TobleMiner/SolarCamPiV2/SolarCamPiV2.kicad_pcb

## KiCad design SolarCamPiV2.kicad_pcb (2022-05-29)

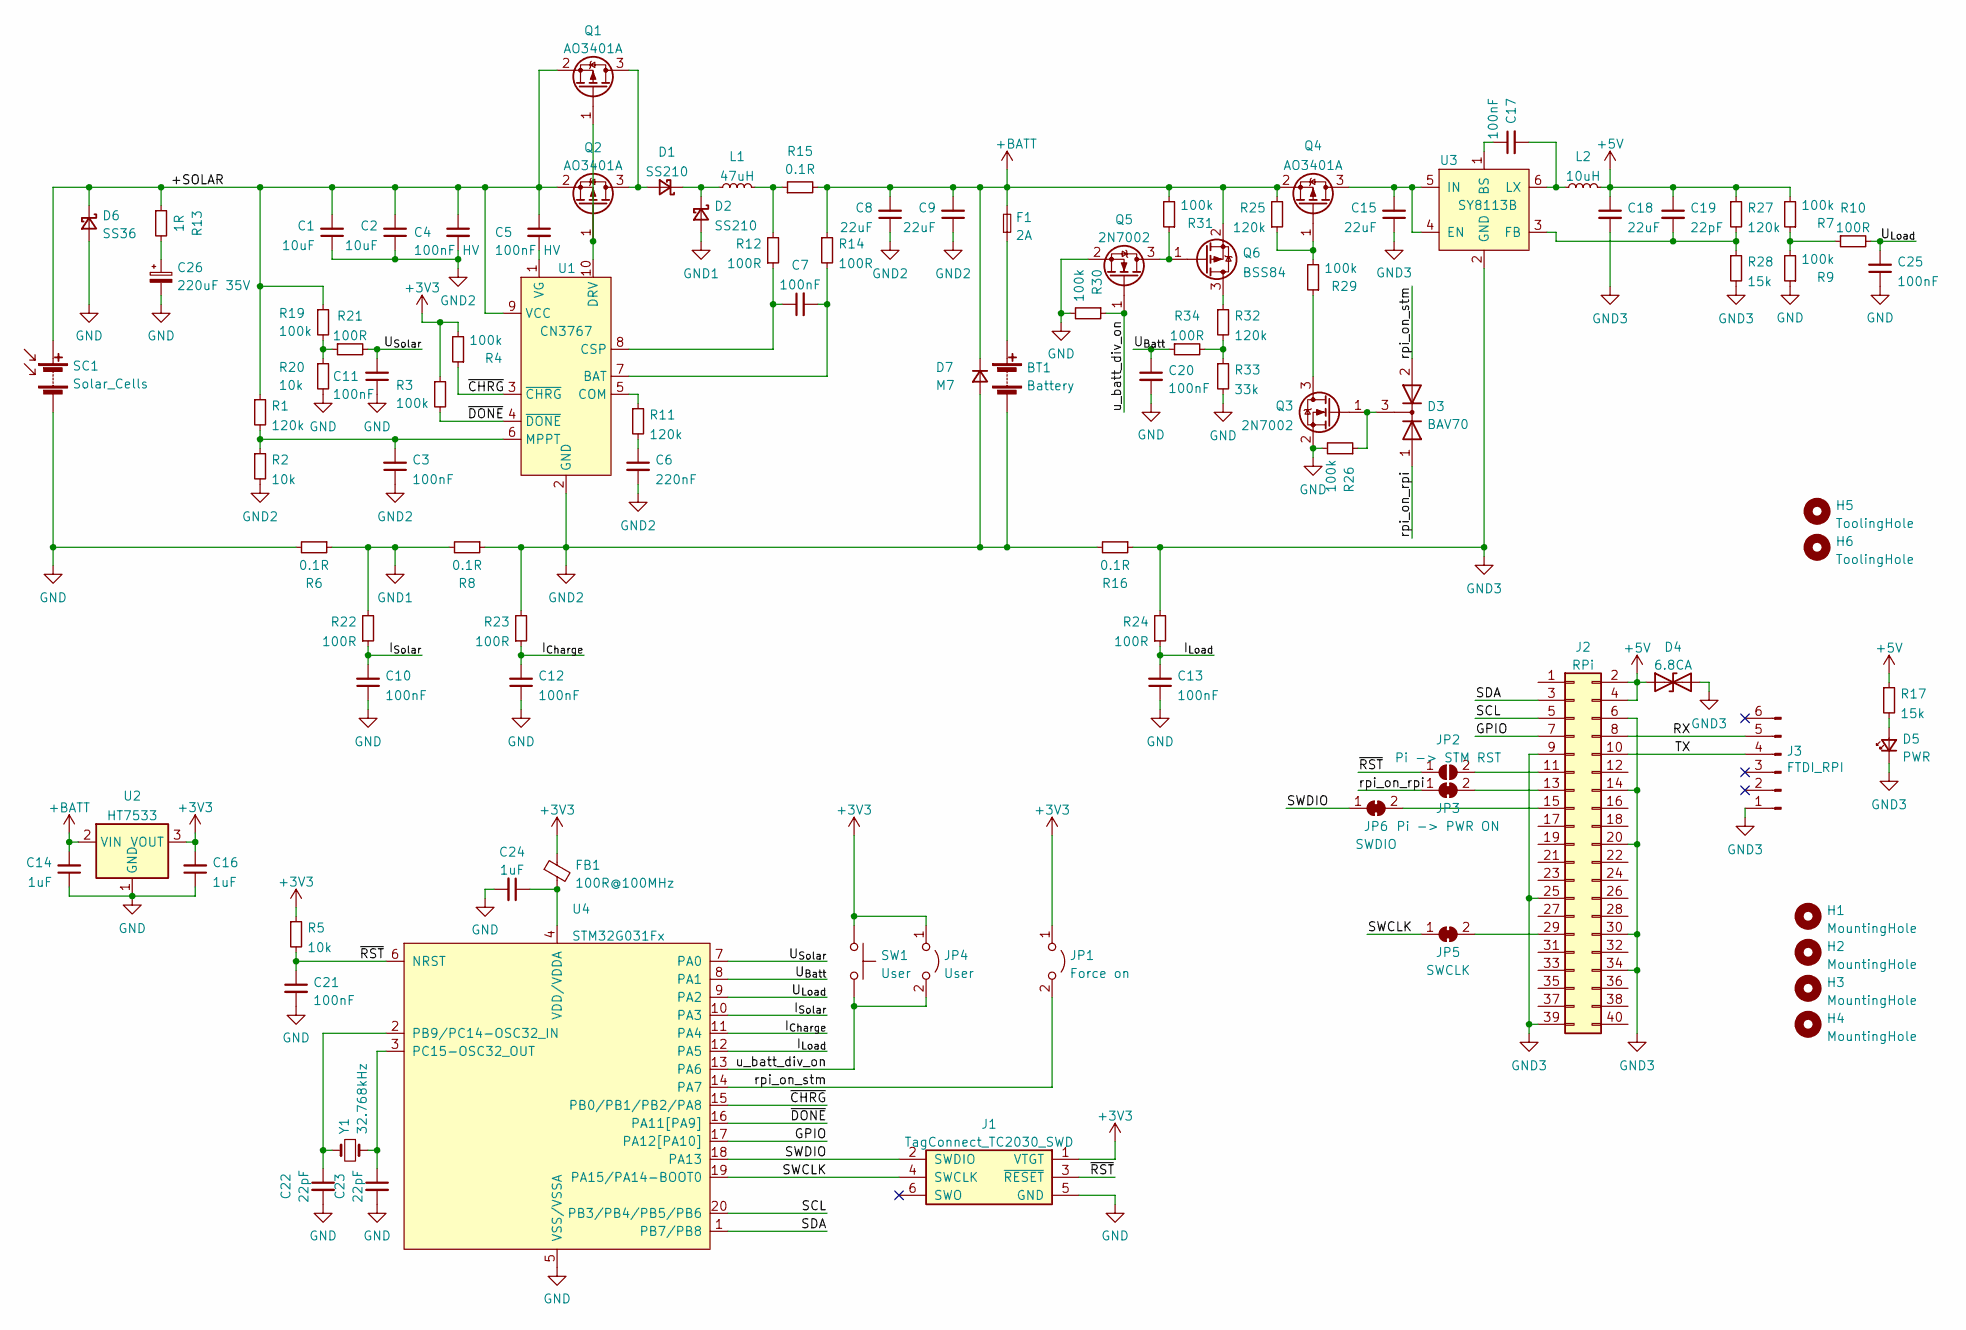
[picture p1: schematic SolarCamPiV2.kicad_sch]

Parts:
BT1: Battery; TerminalBlock_4Ucon_1x02_P3.50mm_Horizontal; LCSC C474892
C1, C2: 10uF; C_1206_3216Metric; LCSC C13585
C3, C7, C10, C11, C12, C13, C17, C20, C21, C25: 100nF; C_0402_1005Metric; LCSC C1525
C4, C5: 100nF HV; C_0603_1608Metric; LCSC C14663
C6: 220nF; C_0402_1005Metric; LCSC C16772
C8, C9, C15, C18: 22uF; C_0805_2012Metric; LCSC C45783
C14, C16, C24: 1uF; C_0402_1005Metric; LCSC C52923
C19, C22, C23: 22pF; C_0402_1005Metric; LCSC C1555
C26: 220uF 35V; CP_Elec_10x10; LCSC C134521
D1, D2: SS210; D_SMA; LCSC C14996
D3: BAV70; SOT-23
D4: 6.8CA; D_SMB; LCSC C78395
D5: PWR; LED_0603_1608Metric; LCSC C72043
D6: SS36; D_SMC; LCSC C35722
D7: M7; D_SMA; LCSC C95872
F1: 2A; Fuse_1206_3216Metric; LCSC C354895
FB1: 100R@100MHz; L_0805_2012Metric; LCSC C1017
H1, H2, H3, H4: MountingHole; MountingHole_2.7mm_M2.5
H5, H6: ToolingHole; ToolingHole_JLCSMT
J1: TagConnect_TC2030_SWD; Tag-Connect_TC2030-IDC-NL_2x03_P1.27mm_Vertical
J2: RPi; PinSocket_2x20_P2.54mm_Vertical
J3: FTDI_RPI; PinHeader_1x06_P2.54mm_Vertical
JP1: Force on; PinHeader_1x02_P2.54mm_Horizontal
JP2: Pi -> STM RST; SolderJumper-2_P1.3mm_Open_Pad1.0x1.5mm
JP3: Pi -> PWR ON; SolderJumper-2_P1.3mm_Bridged_Pad1.0x1.5mm
JP4: User; PinHeader_1x02_P2.54mm_Horizontal
JP5: SWCLK; SolderJumper-2_P1.3mm_Bridged_Pad1.0x1.5mm
JP6: SWDIO; SolderJumper-2_P1.3mm_Bridged_Pad1.0x1.5mm
L1: 47uH; L_Bourns_SRP7028A_7.3x6.6mm; LCSC C149588
L2: 10uH; L_Taiyo-Yuden_MD-4040; LCSC C340393
Q1, Q2, Q4: AO3401A; SOT-23; LCSC C15127
Q3, Q5: 2N7002; SOT-23; LCSC C8545
Q6: BSS84; SOT-23; LCSC C8492
R1, R11, R25, R27, R32: 120k; R_0402_1005Metric; LCSC C25750
R2, R5, R20: 10k; R_0402_1005Metric; LCSC C25744
R3, R4, R7, R9, R19, R26, R29, R30, R31: 100k; R_0402_1005Metric; LCSC C25741
R6, R8, R15, R16: 0.1R; R_1206_3216Metric; LCSC C25334
R10, R12, R14, R21, R22, R23, R24, R34: 100R; R_0402_1005Metric; LCSC C25076
R13: 1R; R_1206_3216Metric; LCSC C17928
R17, R28: 15k; R_0402_1005Metric; LCSC C25756
R33: 33k; R_0402_1005Metric; LCSC C25779
SC1: Solar_Cells; TerminalBlock_4Ucon_1x02_P3.50mm_Horizontal; LCSC C474892
SW1: User; SW_Push_SPST_NO_Alps_SKRK; LCSC C115357
U1: CN3767; SSOP-10_3.9x4.9mm_P1.00mm; LCSC C81968
U2: HT7533; SOT-89-3; LCSC C14289
U3: SY8113B; SOT-23-6; LCSC C78989
U4: STM32G031Fx; TSSOP-20_4.4x6.5mm_P0.65mm; LCSC C724040
Y1: 32.768kHz; Crystal_SMD_3215-2Pin_3.2x1.5mm; LCSC C32346

Connections:
+3V3: C16.2, FB1.1, J1.1 (VTGT), JP1.1 (A), JP4.1 (A), R3.1, R4.2, R5.1, SW1.1, U2.3 (VOUT)
+5V: C18.1, C19.1, D4.1 (A1), J2.2, J2.4, L2.2, R7.2, R17.1, R27.1
+BATT: C8.2, C9.2, C14.2, D7.1 (K), F1.2, Q4.2 (S), Q6.2 (S), R14.1, R15.2, R25.2, R31.2, U2.2 (VIN)
/+SOLAR: C1.2, C2.2, C4.1, C5.1, D6.1 (K), Q1.2 (S), Q2.2 (S), R1.1, R13.1, R19.1, SC1.1 (+), U1.9 (VCC)
/GPIO: J2.7, U4.17 (PA12[PA10])
/I_{Charge}: C12.2, R23.1, U4.11 (PA4)
/I_{Load}: C13.2, R24.1, U4.12 (PA5)
/I_{Solar}: C10.2, R22.1, U4.10 (PA3)
/RX: J2.8, J3.5
/SCL: J2.5, U4.20 (PB3/PB4/PB5/PB6)
/SDA: J2.3, U4.1 (PB7/PB8)
/SWCLK: J1.4 (SWCLK), JP5.1 (A), U4.19 (PA15/PA14-BOOT0)
/SWDIO: J1.2 (SWDIO), JP6.1 (A), U4.18 (PA13)
/TX: J2.10, J3.4
/U_{Batt}: C20.1, R34.1, U4.8 (PA1)
/U_{Load}: C25.2, R10.2, U4.9 (PA2)
/U_{Solar}: C11.2, R21.2, U4.7 (PA0)
/rpi_on_rpi: D3.1 (A), JP3.1 (A)
/rpi_on_stm: D3.2 (A), JP1.2 (B), U4.14 (PA7)
/u_batt_div_on: JP4.2 (B), Q5.1 (G), R30.1, SW1.2, U4.13 (PA6)
/~CHRG: R4.1, U1.3 (~CHRG), U4.15 (PB0/PB1/PB2/PA8)
/~DONE: R3.2, U1.4 (~DONE), U4.16 (PA11[PA9])
/~RST: C21.1, J1.3 (~RESET), JP2.1 (A), R5.2, U4.6 (NRST)
GND: C10.1, C11.1, C12.1, C13.1, C14.1, C16.1, C20.2, C21.2, C22.2, C23.2, C24.2, C25.1, C26.2, D6.2 (A), J1.5 (GND), Q3.2 (S), Q5.2 (S), R6.2, R9.1, R20.2, R26.2, R30.2, R33.2, SC1.2 (-), U2.1 (GND), U4.5 (VSS/VSSA)
GND1: D2.2 (A), R6.1, R8.2, R22.2
GND2: BT1.2 (-), C1.1, C2.1, C3.1, C4.2, C6.2, C8.1, C9.1, D7.2 (A), R2.2, R8.1, R16.2, R23.2, U1.2 (GND)
GND3: C15.1, C18.2, D4.2 (A2), D5.1 (K), J2.6, J2.9, J2.14, J2.20, J2.25, J2.30, J2.34, J2.39, J3.1, R16.1, R24.2, R28.2, U3.2 (GND)
unnamed: BT1.1 (+), F1.1
unnamed: C3.2, R1.2, R2.1, U1.6 (MPPT)
unnamed: C5.2, U1.1 (VG)
unnamed: C6.1, R11.2
unnamed: C7.1, R12.1, U1.8 (CSP)
unnamed: C7.2, R14.2, U1.7 (BAT)
unnamed: C15.2, Q4.3 (D), U3.4 (EN), U3.5 (IN)
unnamed: C17.1, U3.1 (BS)
unnamed: C17.2, L2.1, U3.6 (LX)
unnamed: C19.2, R27.2, R28.1, U3.3 (FB)
unnamed: C22.1, U4.2 (PB9/PC14-OSC32_IN), Y1.2
unnamed: C23.1, U4.3 (PC15-OSC32_OUT), Y1.1
unnamed: C24.1, FB1.2, U4.4 (VDD/VDDA)
unnamed: C26.1, R13.2
unnamed: D1.1 (K), D2.1 (K), L1.1
unnamed: D1.2 (A), Q1.3 (D), Q2.3 (D)
unnamed: D3.3 (K), Q3.1 (G), R26.1
unnamed: D5.2 (A), R17.2
unnamed: J2.11, JP2.2 (B)
unnamed: J2.13, JP3.2 (B)
unnamed: J2.15, JP6.2 (B)
unnamed: J2.29, JP5.2 (B)
unnamed: L1.2, R12.2, R15.1
unnamed: Q1.1 (G), Q2.1 (G), U1.10 (DRV)
unnamed: Q3.3 (D), R29.1
unnamed: Q4.1 (G), R25.1, R29.2
unnamed: Q5.3 (D), Q6.1 (G), R31.1
unnamed: Q6.3 (D), R32.1
unnamed: R7.1, R9.2, R10.1
unnamed: R11.1, U1.5 (COM)
unnamed: R19.2, R20.1, R21.1
unnamed: R32.2, R33.1, R34.2

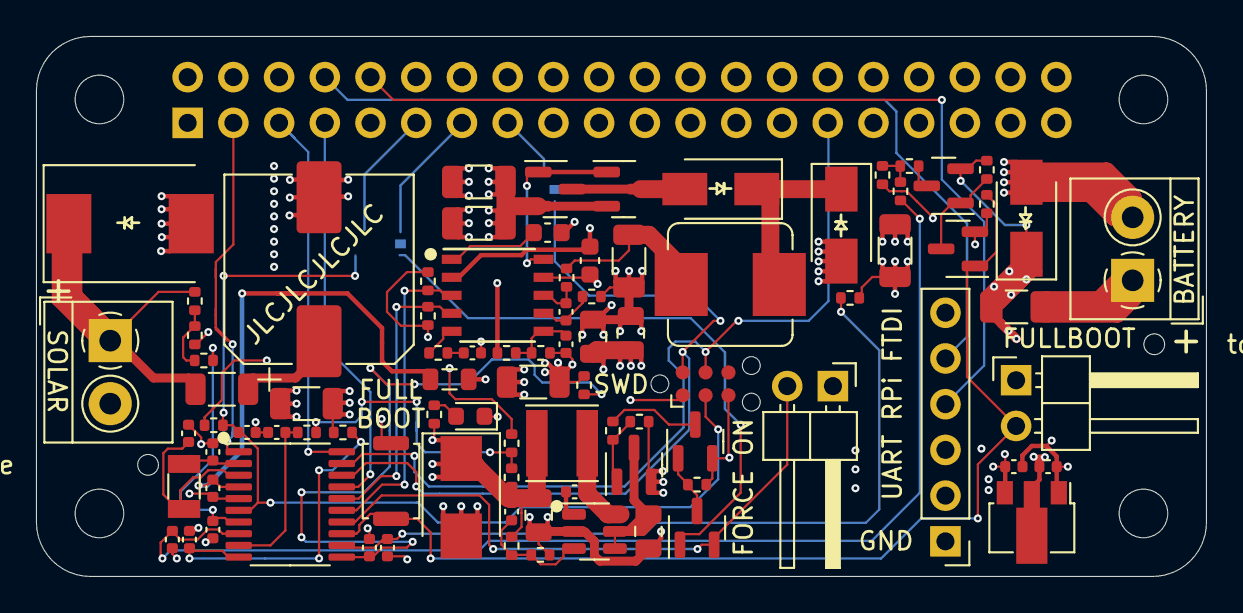
[picture p2: board SolarCamPiV2.kicad_pcb from above]

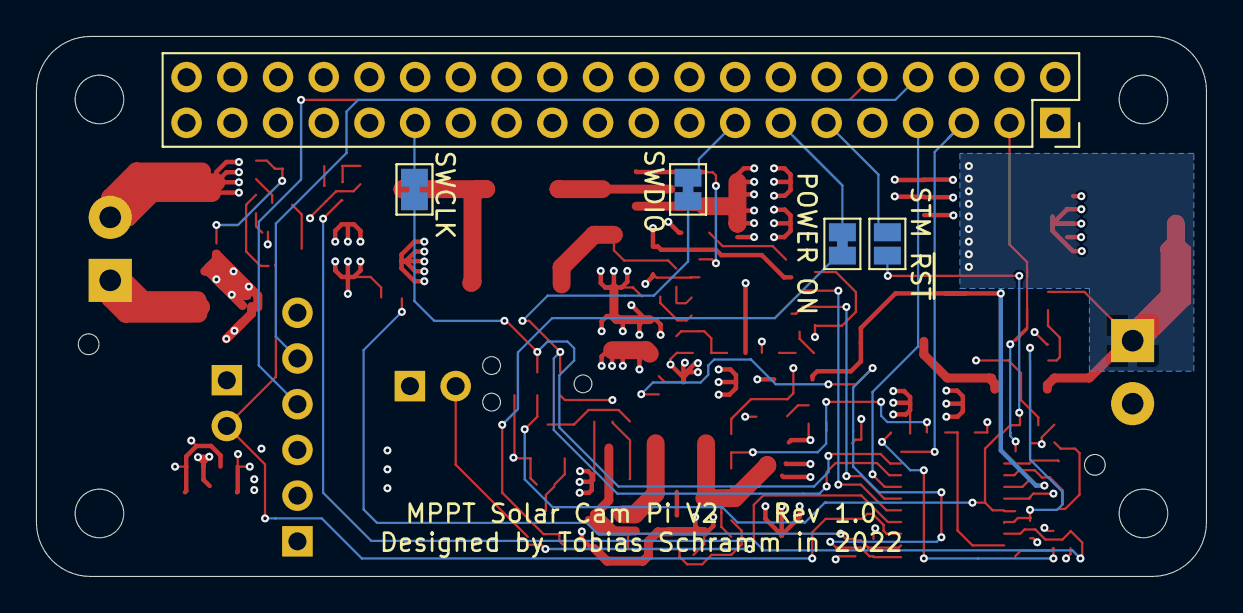
[picture p3: board SolarCamPiV2.kicad_pcb from below]

Board: 4 copper layers, 65.0 x 30.0 mm, 99 parts (5 on the bottom side), 59 nets.
