TobleMiner/SolarCamPiV2/(commit log)

2022-04-16 Add RPi socket
    [SolarCamPiV2.kicad_sch]
2022-04-16 Change MTTP charge current setpoint to 1.2A
    [SolarCamPiV2.kicad_sch]
2022-04-16 Add battery fuse
    [SolarCamPiV2.kicad_sch]
2022-04-16 Add reverse polarity protection
    [SolarCamPiV2.kicad_pcb, SolarCamPiV2.kicad_sch]
2022-04-16 Fix Q2 polarity
    [SolarCamPiV2.kicad_sch]
2022-04-18 Layout power conversion subcomponents
    [SolarCamPiV2.kicad_pcb, SolarCamPiV2.kicad_sch]
2022-05-29 Finish component placement
    [SolarCamPiV2.kicad_pcb, SolarCamPiV2.kicad_sch]
2022-05-29 Finish routing
    [SolarCamPiV2.kicad_pcb]
2022-05-29 DFM, add pin 1 designators
    [SolarCamPiV2.kicad_pcb]
2022-05-29 Connect SWD to RPi GPIOs
    [SolarCamPiV2.kicad_pcb, SolarCamPiV2.kicad_sch]
2022-05-29 Add 3d models
    [SolarCamPiV2.kicad_pcb]
2022-05-29 Add fabrication files
    [SolarCamPiV2-B_Cu.gbl, SolarCamPiV2-B_Mask.gbs, SolarCamPiV2-B_Paste.gbp, SolarCamPiV2-B_Silkscreen.gbo, SolarCamPiV2-Edge_Cuts.gm1, SolarCamPiV2-F_Cu.gtl, SolarCamPiV2-F_Mask.gts, SolarCamPiV2-F_Paste.gtp]
